capantoja/SIMM/SIMM/Hardware/Perifericos/Datasheet/ElecFreaks - Wiki_files/700px-NewTFT2.4-04-LGR.jpg

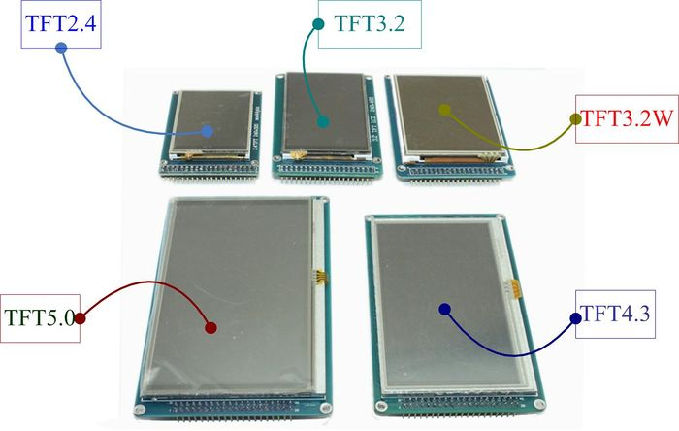
SIMM/Hardware/Perifericos/Datasheet/ElecFreaks - Wiki_files/700px-NewTFT2.4-04-LGR.jpg
