capantoja/SIMM/SIMM/Hardware/Perifericos/Datasheet/ElecFreaks - Wiki_files/450px-NewTFT4.3-01-LGR.jpg

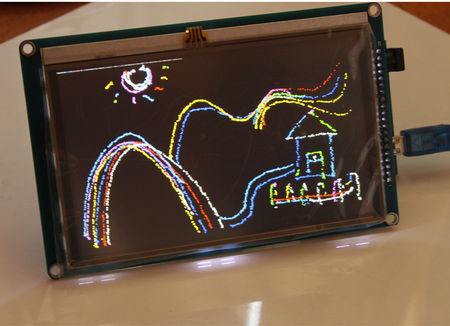
SIMM/Hardware/Perifericos/Datasheet/ElecFreaks - Wiki_files/450px-NewTFT4.3-01-LGR.jpg
