capantoja/SIMM/SIMM/Hardware/Perifericos/Datasheet/ElecFreaks - Wiki_files/450px-NewTFT4.3-02-LGR.jpg

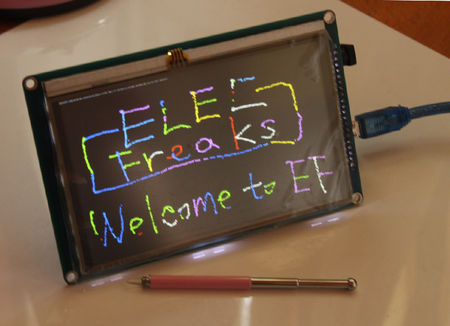
SIMM/Hardware/Perifericos/Datasheet/ElecFreaks - Wiki_files/450px-NewTFT4.3-02-LGR.jpg
