capantoja/SIMM/SIMM/Hardware/Perifericos/Datasheet/ElecFreaks - Wiki_files/450px-NewTFT.jpg

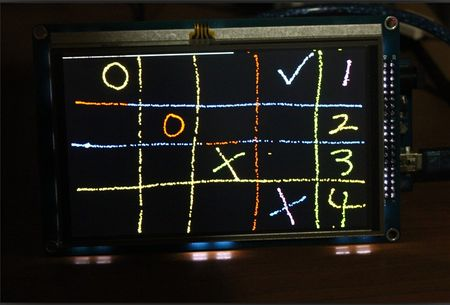
SIMM/Hardware/Perifericos/Datasheet/ElecFreaks - Wiki_files/450px-NewTFT.jpg
