capantoja/SIMM/SIMM/Hardware/Perifericos/Datasheet/ElecFreaks - Wiki_files/500px-TFT01-2.4-04.jpg

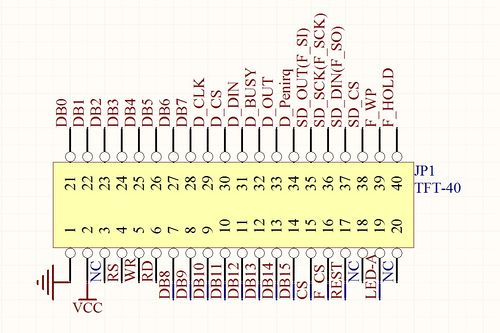
SIMM/Hardware/Perifericos/Datasheet/ElecFreaks - Wiki_files/500px-TFT01-2.4-04.jpg
