capantoja/SIMM/SIMM/Hardware/Perifericos/Datasheet/ElecFreaks - Wiki_files/500px-TFT4.3.jpg

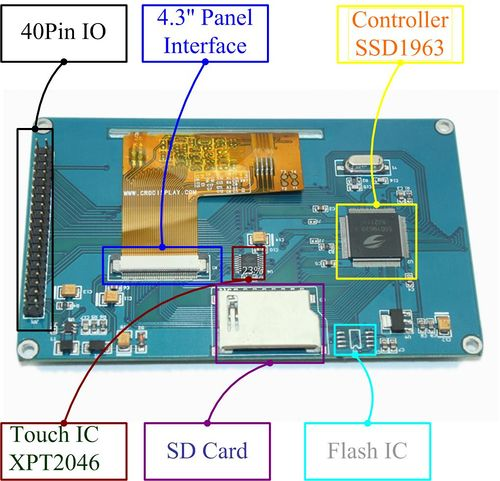
SIMM/Hardware/Perifericos/Datasheet/ElecFreaks - Wiki_files/500px-TFT4.3.jpg
