capantoja/SIMM/SIMM/Hardware/Perifericos/Datasheet/ElecFreaks - Wiki_files/600px-NewTFT4.3.jpg

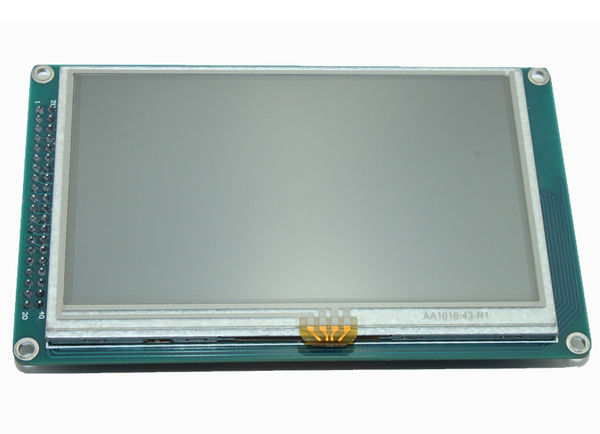
SIMM/Hardware/Perifericos/Datasheet/ElecFreaks - Wiki_files/600px-NewTFT4.3.jpg
