capantoja/SIMM/SIMM/Hardware/Perifericos/Datasheet/ElecFreaks - Wiki_files/700px-NewTFT4.3-06-LGR.jpg

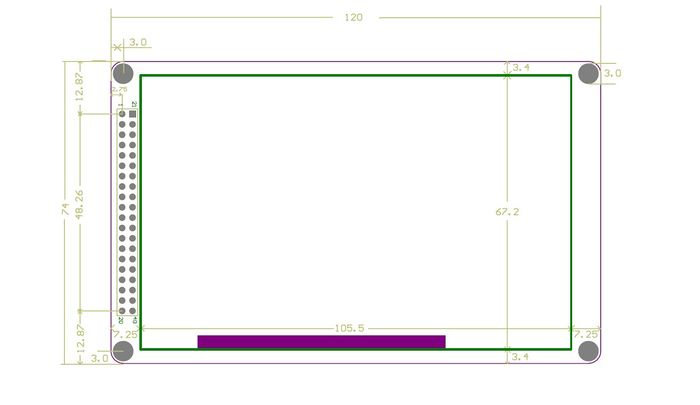
SIMM/Hardware/Perifericos/Datasheet/ElecFreaks - Wiki_files/700px-NewTFT4.3-06-LGR.jpg
