capantoja/SIMM/SIMM/Hardware/Perifericos/Datasheet/ElecFreaks - Wiki_files/700px-RGB.jpg.png

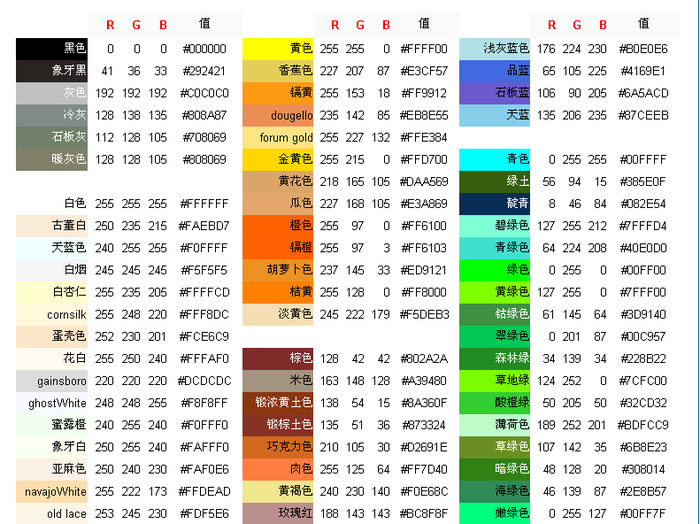
SIMM/Hardware/Perifericos/Datasheet/ElecFreaks - Wiki_files/700px-RGB.jpg.png
