capantoja/SIMM/SIMM/Hardware/Perifericos/Datasheet/Skylab GPS Module MT3329 SKM53 with Embedded GPS Antenna Arduino Compatible L   eBay_files/140.jpg

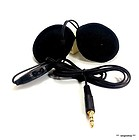
SIMM/Hardware/Perifericos/Datasheet/Skylab GPS Module MT3329 SKM53 with Embedded GPS Antenna Arduino Compatible L eBay_files/140.jpg
