capantoja/SIMM/SIMM/Hardware/Perifericos/Datasheet/Skylab GPS Module MT3329 SKM53 with Embedded GPS Antenna Arduino Compatible L   eBay_files/$(KGrHqUOKpIFGLuYINLOBRntztY36w~~60_1.JPG

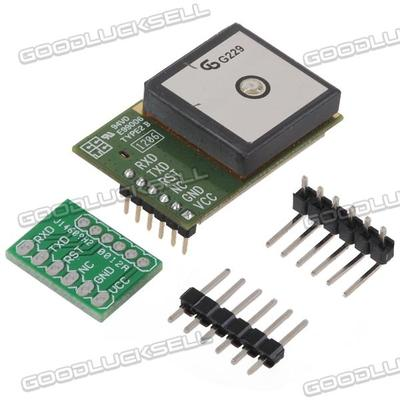
SIMM/Hardware/Perifericos/Datasheet/Skylab GPS Module MT3329 SKM53 with Embedded GPS Antenna Arduino Compatible L eBay_files/$(KGrHqUOKpIFGLuYINLOBRntztY36w~~60_1.JPG
