capantoja/SIMM/SIMM/Hardware/Perifericos/Datasheet/Skylab GPS Module MT3329 SKM53 with Embedded GPS Antenna Arduino Compatible L   eBay_files/sku_86236_2.jpg

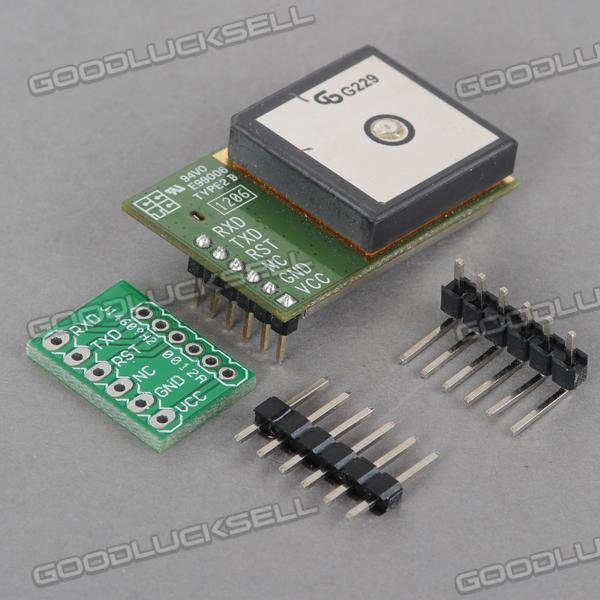
SIMM/Hardware/Perifericos/Datasheet/Skylab GPS Module MT3329 SKM53 with Embedded GPS Antenna Arduino Compatible L eBay_files/sku_86236_2.jpg
