capantoja/SIMM/SIMM/Hardware/Perifericos/img001.jpg

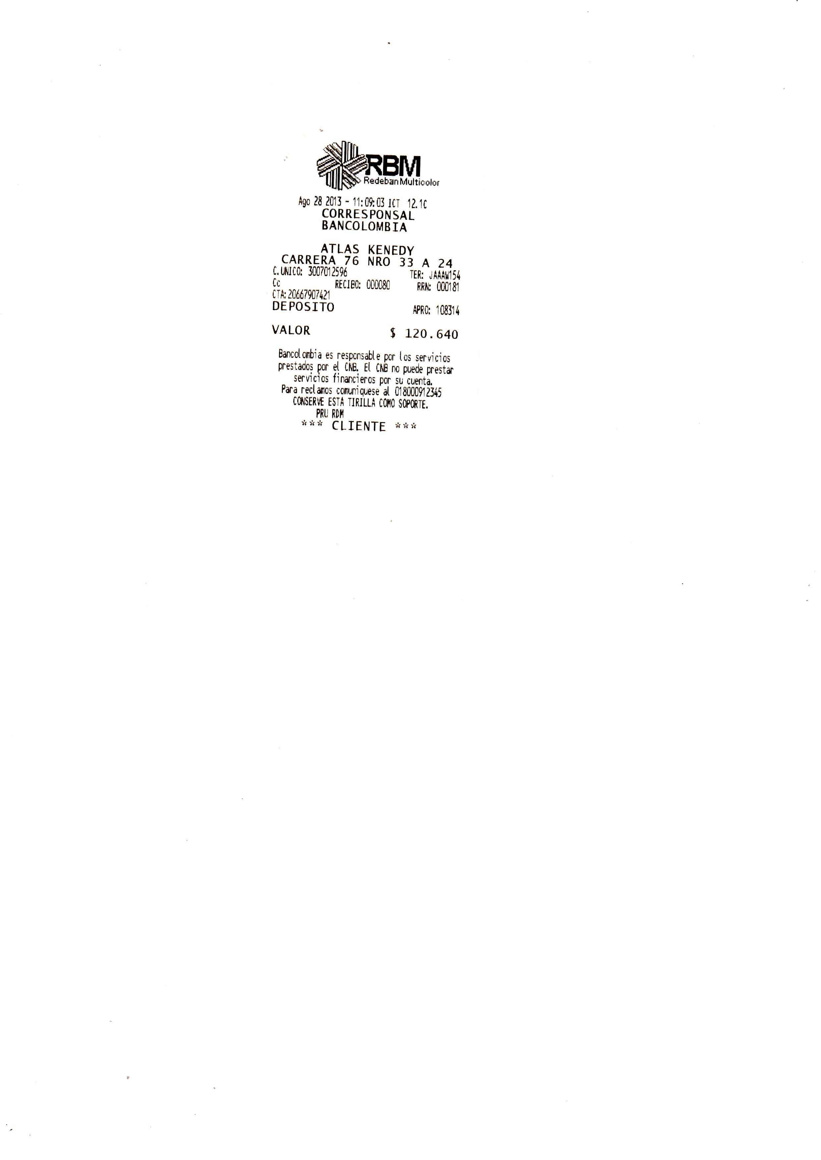
SIMM/Hardware/Perifericos/img001.jpg
