capantoja/SIMM/SIMM/Software/SIMM/Fondo.png

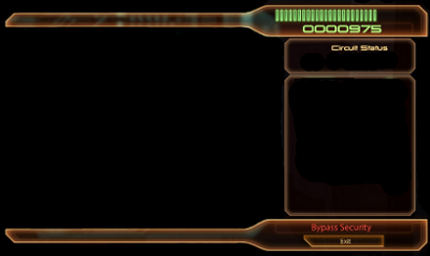
SIMM/Software/SIMM/Fondo.png
