capantoja/SIMM/SIMM/Hardware/Perifericos/BOM.pdf

### Sheet1

### Page 1

DESCRIPCION | ORDEN | ENCAPSULADO | CANTIDAD | PROVEEDOR | REFERENCIA | CODIGO | VALOR UNITARIO | VALOR TOTAL
50pF | C7 | SM0402 | 1 | Sigma | CC0402 68PF50V | | 58 | 580
0.1uF | C6 | SM0805 | 1 | Sigma | CC0805 0.1UF50 | | 58 | 580
0.47uF | C3 | SM1206 | 1 | Tekcien | CC1206CX7R4 | QP0605 | 600 | 600
1uF | C2,C5 | SM0805 | 2 | YO | | | 0 | 0
10uF | C1 | SM1206 | 1 | YO | | | 0 | 0
33uF ELEC | C4 | SM1206 | 1 | Tekcien | | QX0300 | 500 | 500
DIODO ZENER 5V1 | D1,D2,D3,D4,D5,D6 THRU HOLE | | 6 | Av 9 | | | 200 | 1200
CONN AUDIO JACK | J1 | SMD | 1 | Sigma | CON 3.5MM SMD | | 754 | 754
USB CONN | J2 | SMD | 1 | yo | | | 0 | 0
USB MINI CONN | J3 | THRU HOLE | 1 | yo | | | 0 | 0
JUMPER | JP4 | THRU HOLE | 1 | Av 9 | | | 200 | 200
CONN | K1 | THRU HOLE | 1 | Av 9 | | | 200 | 200
FERRITE 500 OHM | L1,L2,L3,L4,L5,L6 SM0805 | | 6 | Sigma | MI0805K400R | | 290 | 1740
CONN 12X2 | P1,P2,P3,P4 | THRU HOLE | 4 | Sigma | REGLETA 40 X 2 | | 435 | 1740
CONN GPS | P5 | THRU HOLE | 1 | Av 9 | | | 200 | 200
CONN 2 | P6 | THRU HOLE | 1 | Av 9 | | | 200 | 200
CONN 10 | P7 | THRU HOLE | 1 | Av 9 | | | 700 | 700
BNC CONN | P8 | THRU HOLE | 1 | Av 9 | | | 700 | 700
RES 100 OHM | R7,R8 | SM1206 | 2 | Sigma | | | 35 | 350
RES 470 OHM | R11,R12,R13,R14,R15,R16,R20,R21,R22,R23,R24,R25 SM1206 | | 12 | Sigma | | | 35 | 700
RES 10K OHM | R1,R2,R17,R18,R19 SM1206 | | 5 | Sigma | | | 35 | 350
RES 47K OHM | R26,R27,R28 | SM1206 | 3 | Sigma | | | 35 | 350
RES 100K OHM | R3,R4,R5,R6,R29,R30,R31,R32,R33,R34 SM1206 | | 10 | Sigma | | | 35 | 350
MINI SWITCH | SW1,SW2,SW3,SW4 SM1206 | | 4 | Av9 | | | 600 | 2400
ESD9B3.3ST5G | TVS1,TVS2 | SM1206 | 2 | | | | 0 | 0
LM2940 | U1 | TO-220ECS | 1 | Sigma | LM2940CT-5 | | 2900 | 2900
MOCD213 | U2,U3,U4 | SOIC8 | 3 | Sigma | MOCD213 | | 1914 | 5742
LM324M | U5 | SOP14 | 1 | Sigma | LM324M | | 638 | 638
| | | | | | | SUBTOTAL | 23674
| | | | | | | IVA APROX | 3787,84
| | | | | | | TOTAL APROX | 27461,84
