capantoja/SIMM/SIMM/Hardware/StampMini/i.mx233stamp.pdf

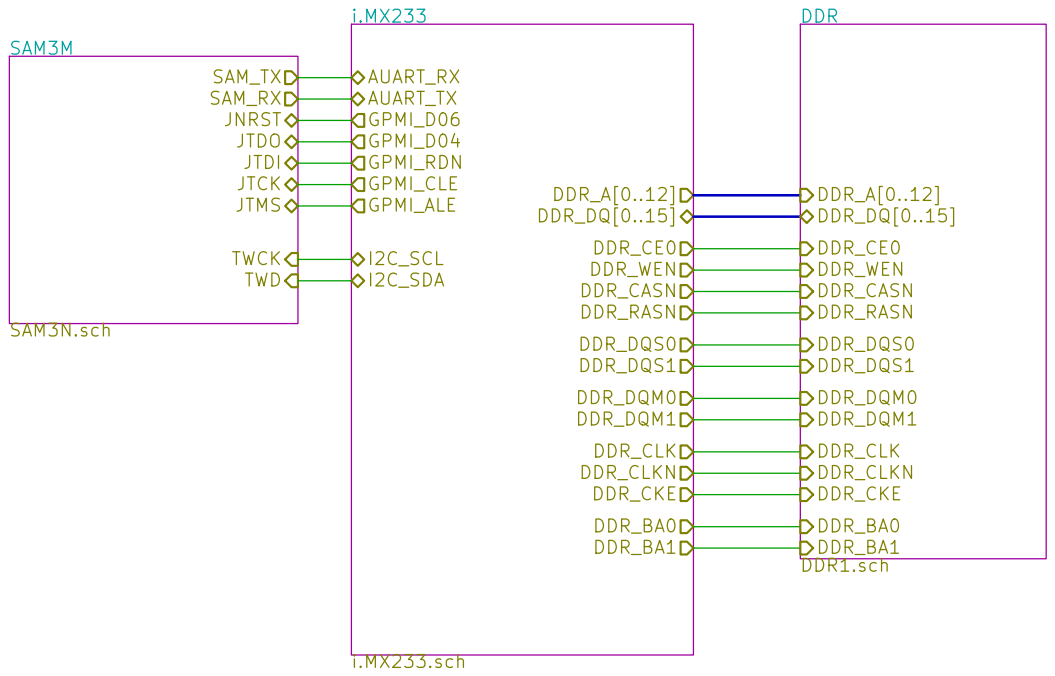
[picture p19: page 1]

Id: 1/4 Title: File: i.mx233stamp.sch
Sheet: /

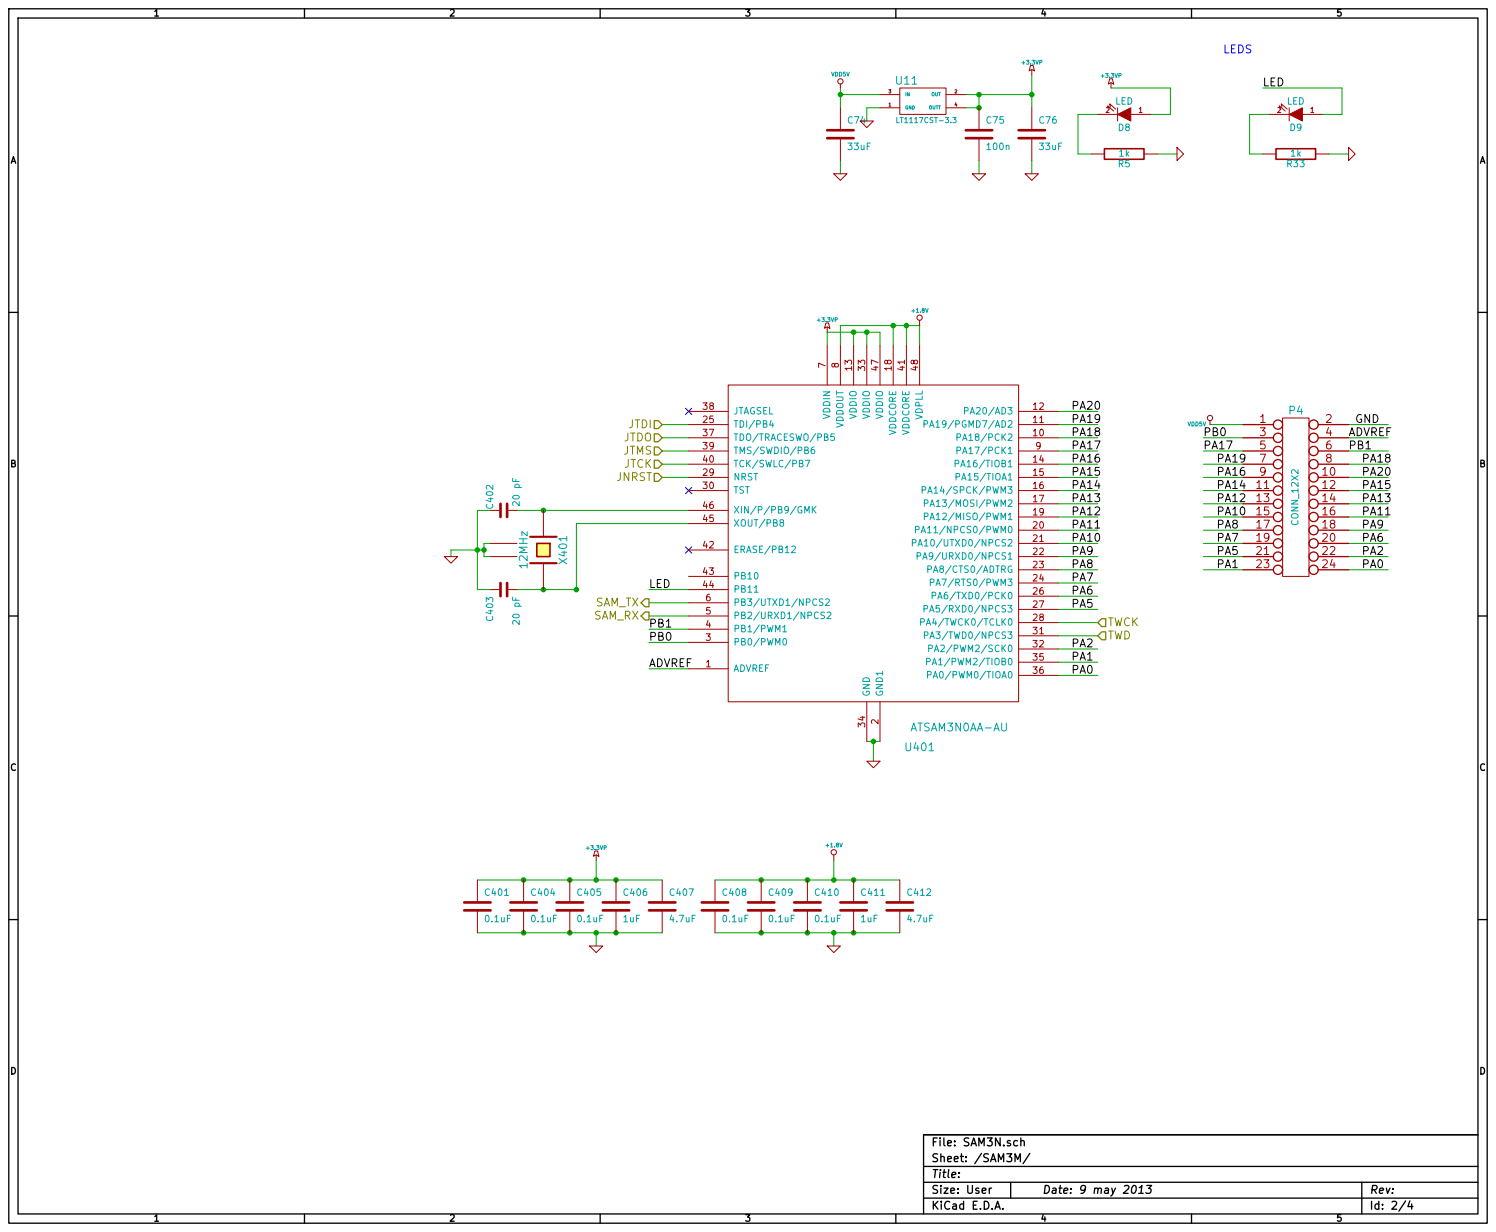
[picture p20: page 2]

8 PA17/PCK1 9 PA18/PCK2 10 PA11/NPCS0/PWM0 20 TST 30 TCK/SWLC/PB7 40 PA19/PGMD7/AD2 11 PA10/UTXD0/NPCS2 21 PA3/TWD0/NPCS3 31 VDDCORE 41 PA20/AD3 12 PA9/URXD0/NPCS1 22 PA2/PWM2/SCK0 32 ERASE/PB12 42 VDDIO 13 PA8/CTS0/ADTRG 23 VDDIO 33 PB10 43 PA16/TIOB1 14 PA7/RTS0/PWM3 24 GND 34 PB11 44 PA15/TIOA1 15 TDI/PB4 25 PA1/PWM2/TIOB0 35 XOUT/PB8 45 PA14/SPCK/PWM3 16 PA6/TXD0/PCK0 26 PA0/PWM0/TIOA0 36 XIN/P/PB9/GMK 46 PA13/MOSI/PWM2 17 PA5/RXD0/NPCS3 27 TDO/TRACESWO/PB5 37 VDDIO 47 VDDCORE 18 PA4/TWCK0/TCLK0 28

Id: 2/4 Title: File: SAM3N.sch
Sheet: /SAM3M/

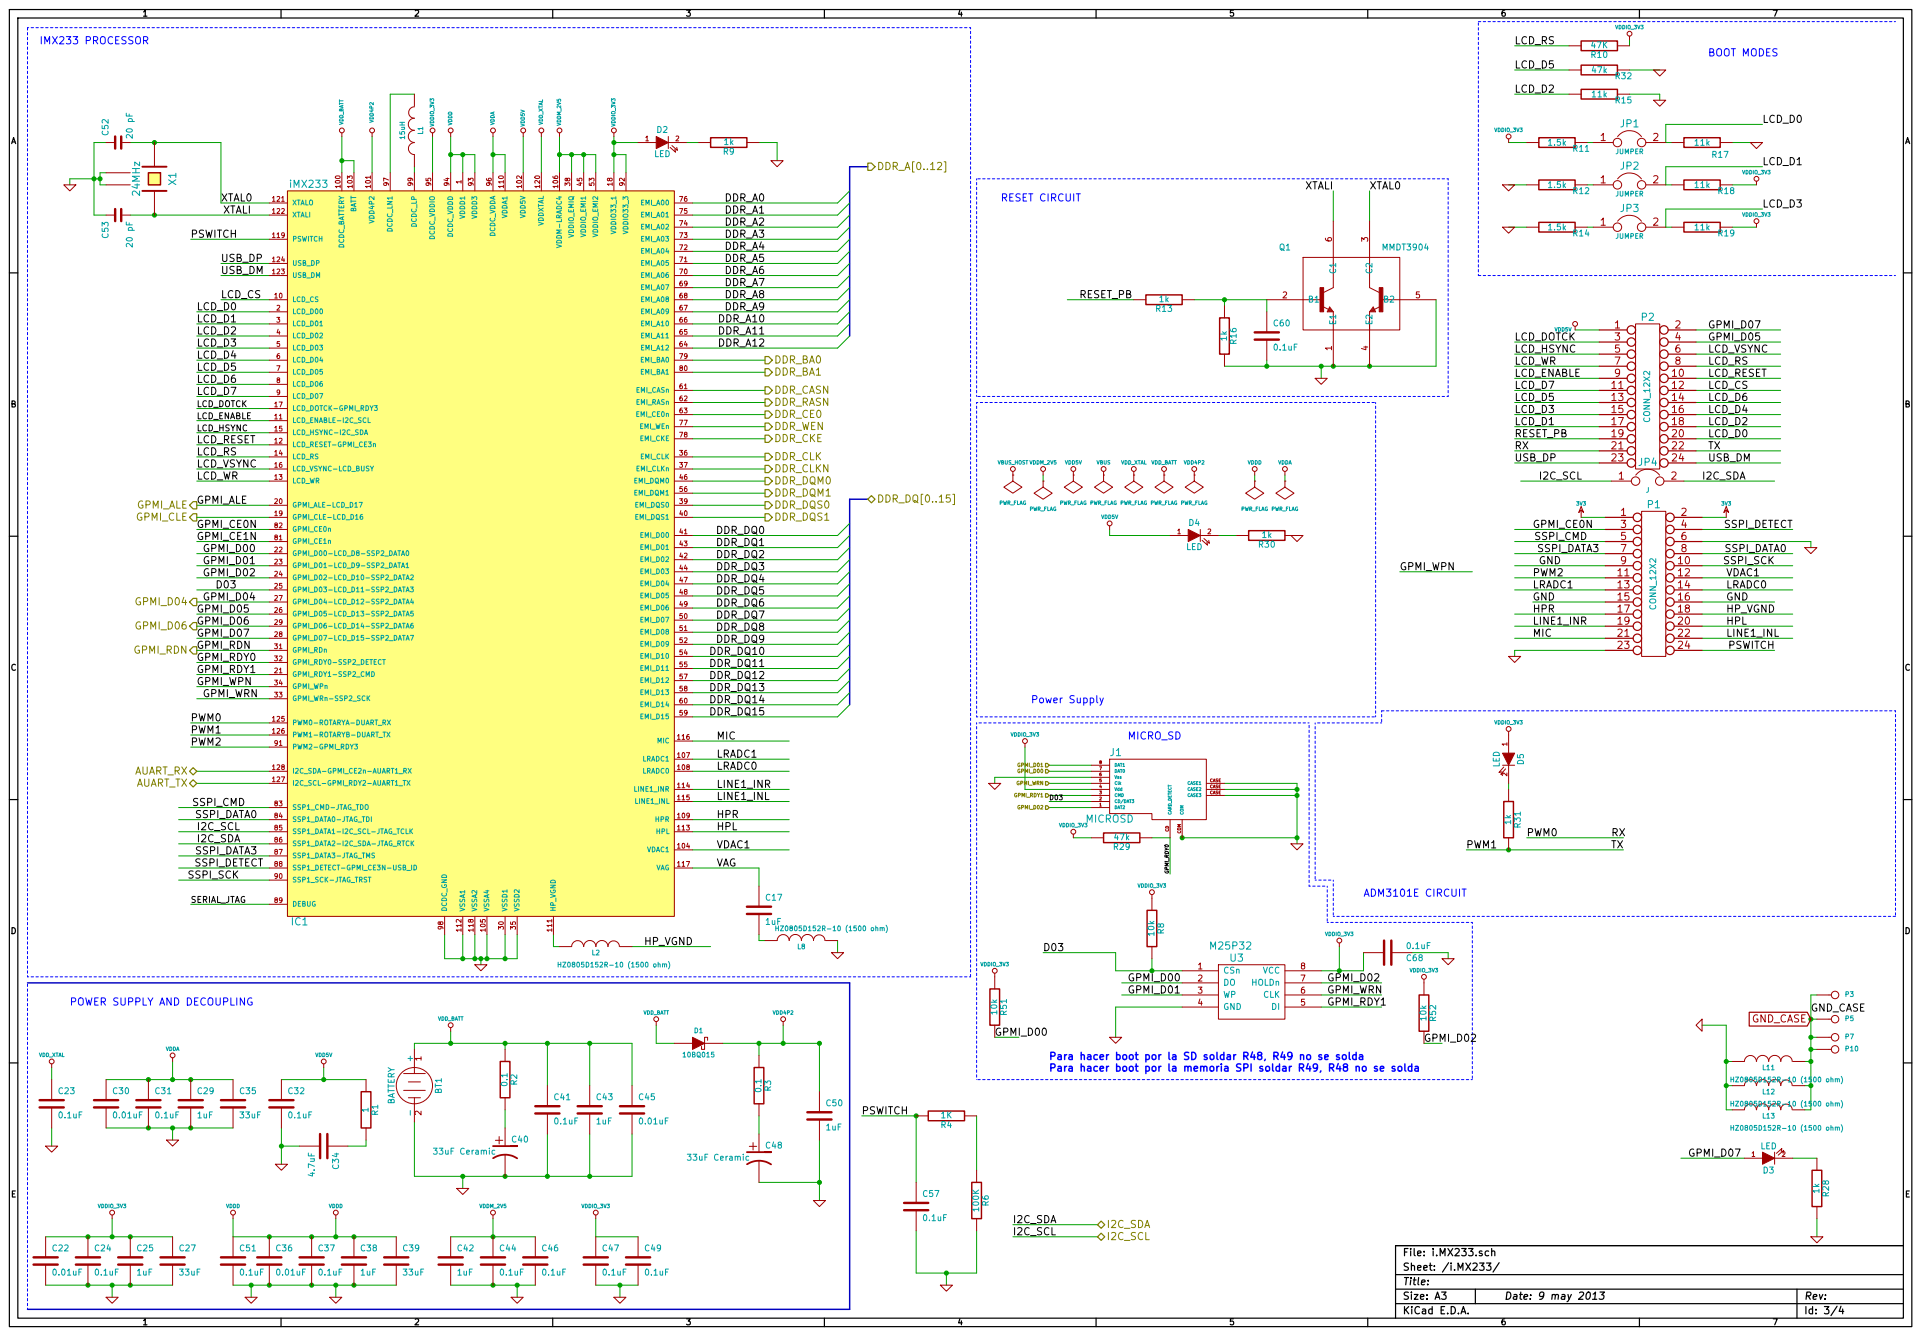
[picture p21: page 3]

Schematic Symbol Drawn By Opendous Inc. www.opendous.org VDDD1

POWER SUPPLY AND DECOUPLING

Para hacer boot por la SD soldar R48, R49 no se solda
Para hacer boot por la memoria SPI soldar R49, R48 no se solda

Id: 3/4 Title: File: i.MX233.sch Sheet: /i.MX233/

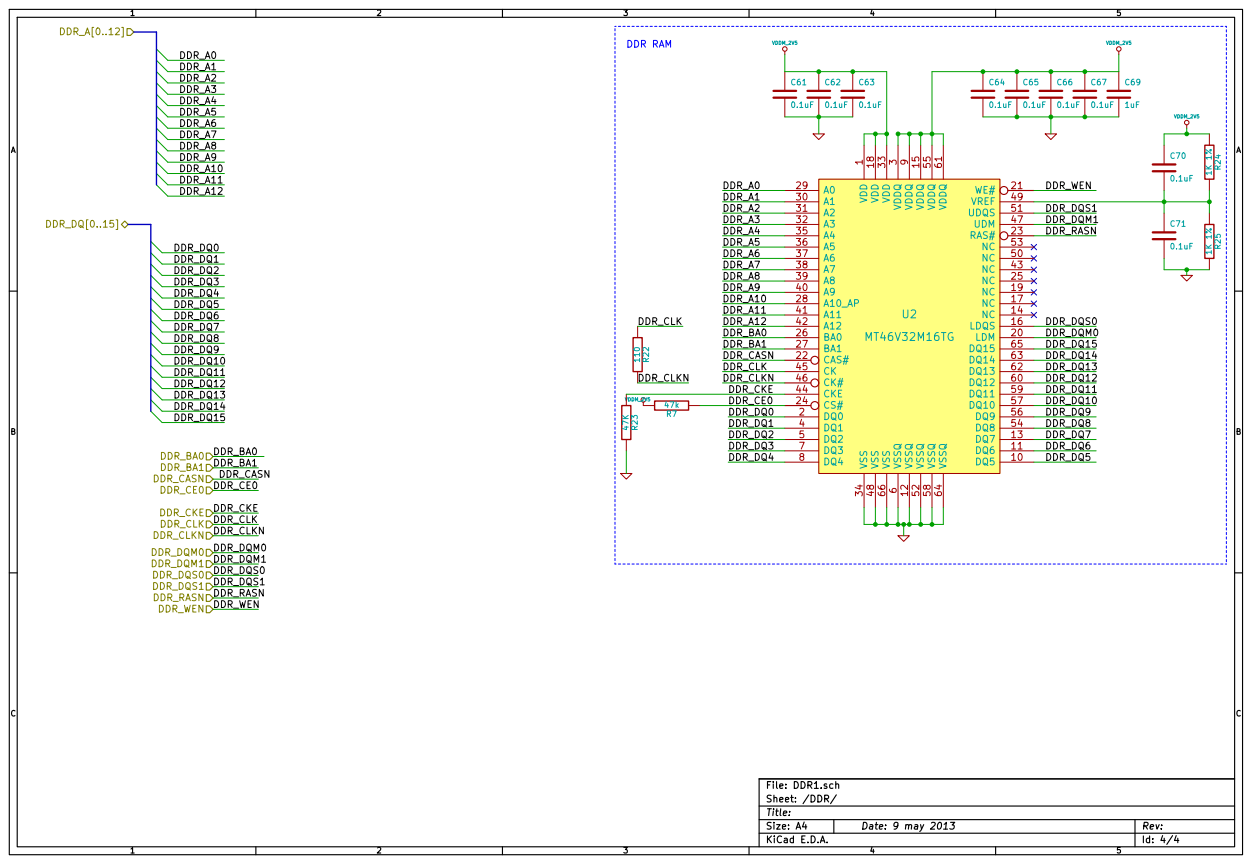
[picture p22: page 4]

Id: 4/4 Title: File: DDR1.sch Sheet: /DDR/
