capantoja/SIMM/SIMM/Hardware/Perifericos/ENTRADAS.sch

## KiCad design SIMM/Hardware/Perifericos/ENTRADAS.sch (2013-09-26)

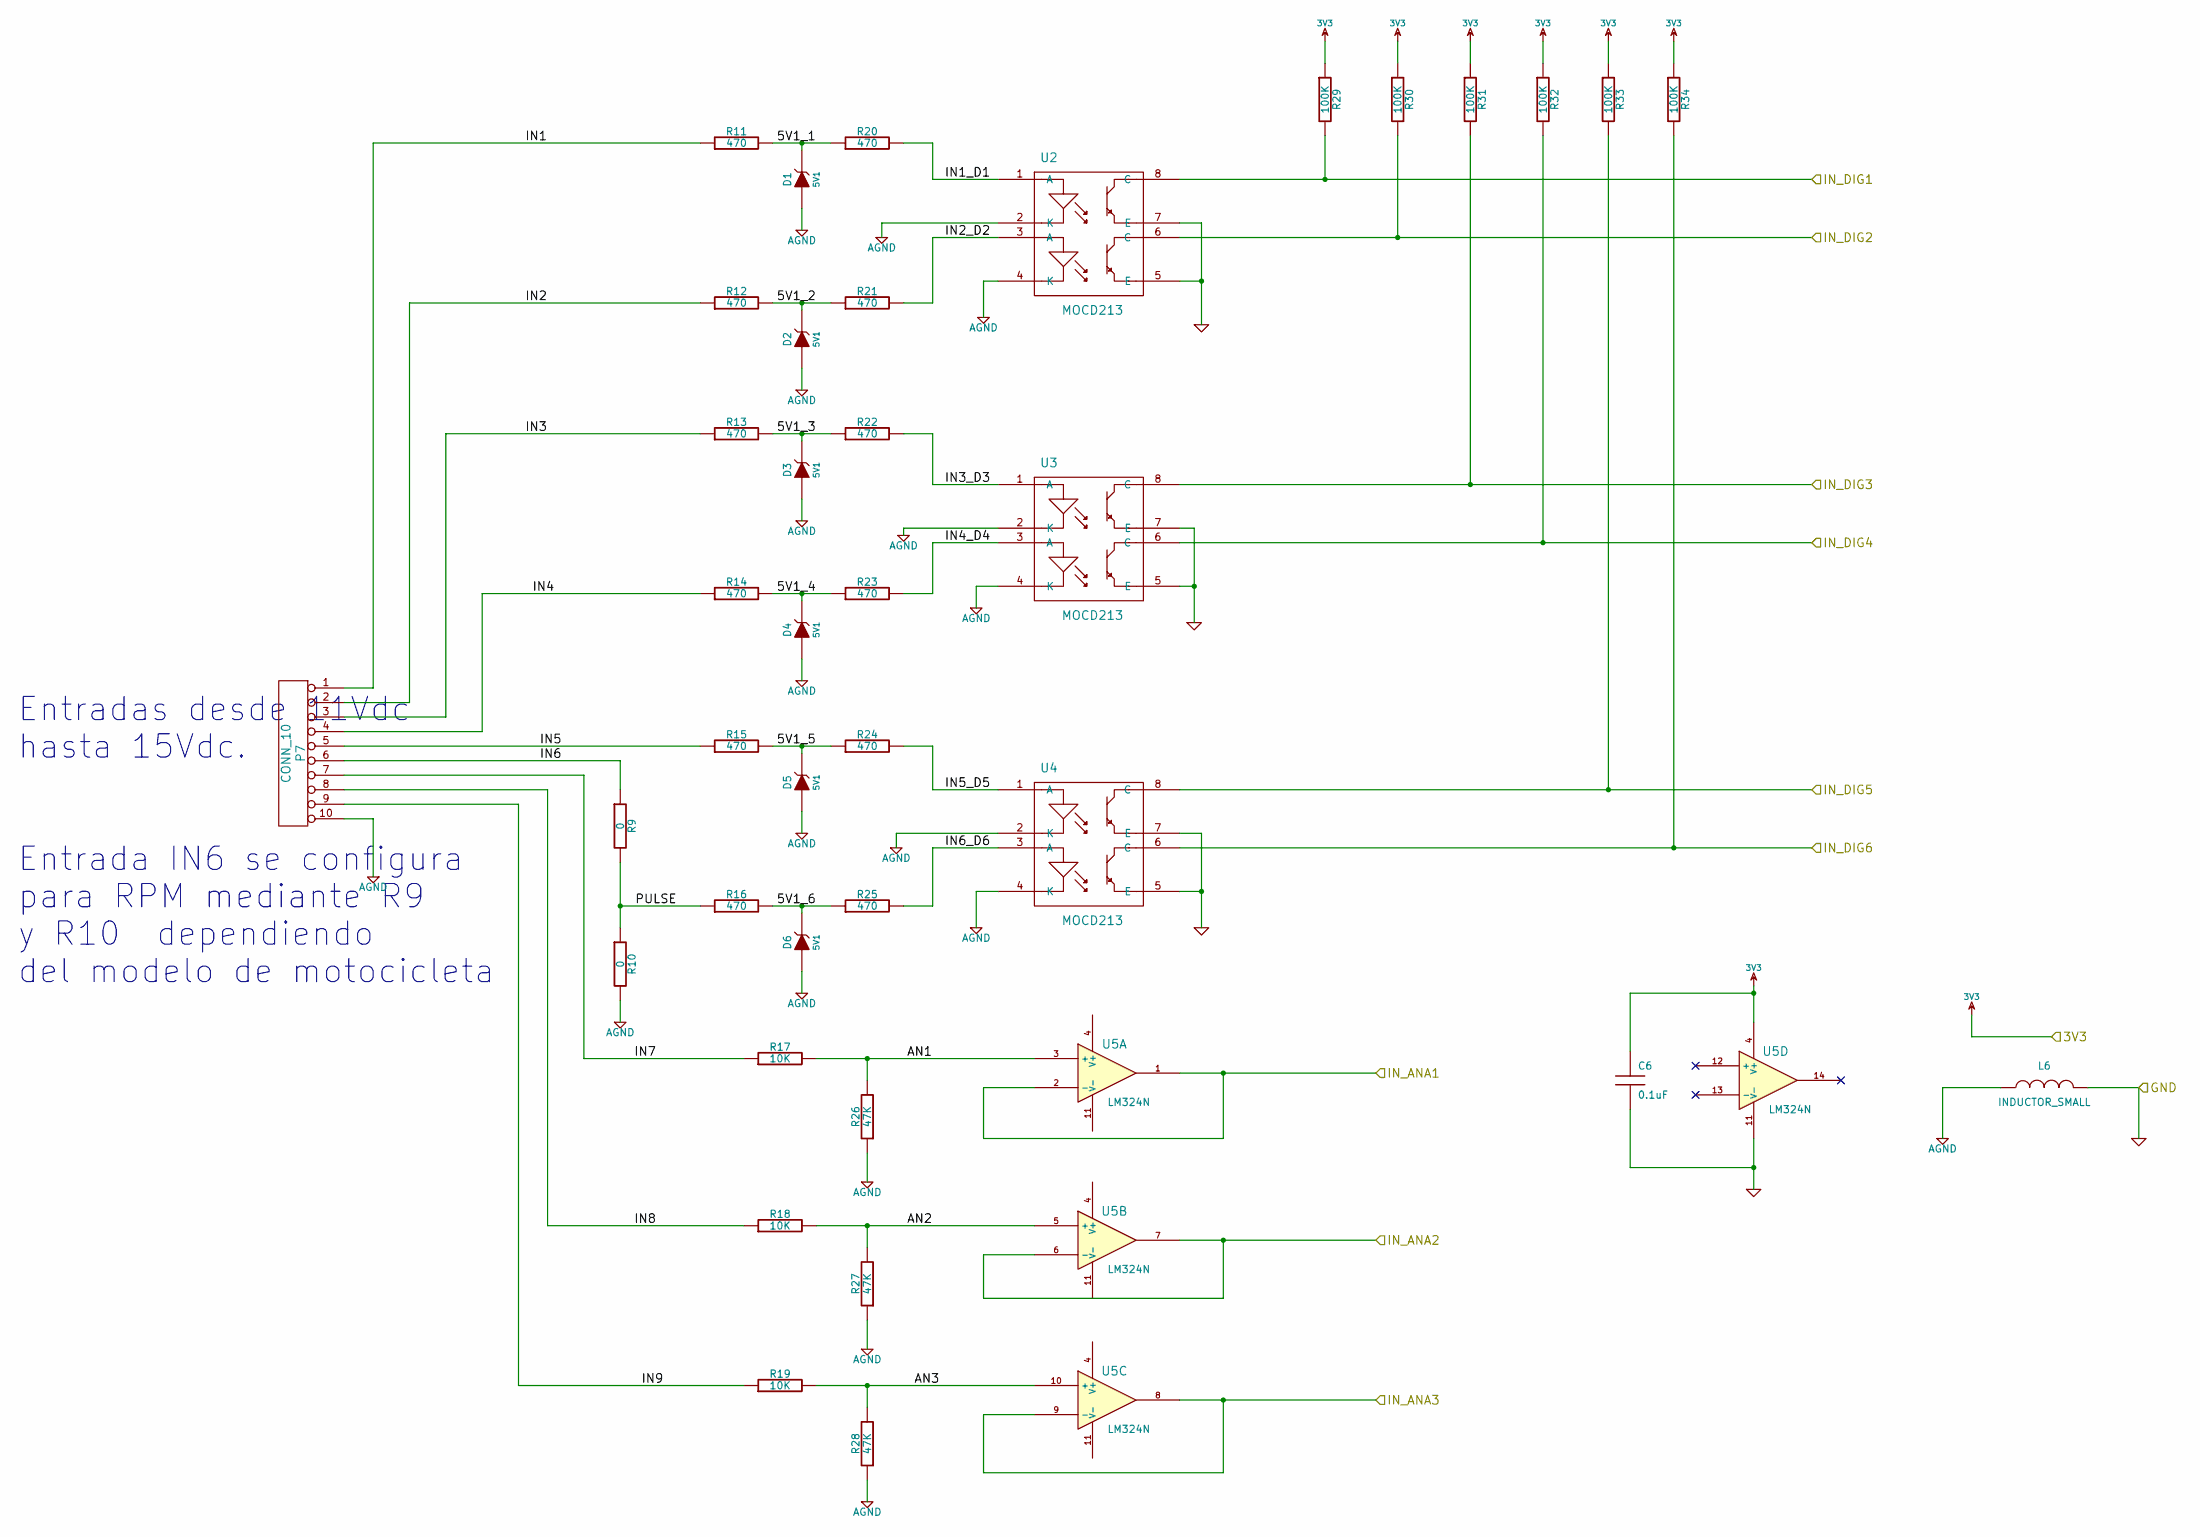
[picture p23: schematic ENTRADAS.sch]

Parts:
C6: 0.1uF; SM0805
D1, D2, D3, D4, D5, D6: 5V1
L6: INDUCTOR_SMALL
P7: CONN_10
R9, R10: 0
R11, R12, R13, R14, R15, R16, R20, R21, R22, R23, R24, R25: 470
R17, R18, R19: 10K; SM0805
R26, R27, R28: 47K; SM0805
R29, R30, R31, R32, R33, R34: 100K; SM0805
U2, U3, U4: MOCD213
U5: LM324N

Connections:
3V3: C6.1, R29.1, R30.1, R31.1, R32.1, R33.1, R34.1, U5.4 (V+)
5V1_1: D1.2 (K), R11.2, R20.1
5V1_2: D2.2 (K), R12.2, R21.1
5V1_3: D3.2 (K), R13.2, R22.1
5V1_4: D4.2 (K), R14.2, R23.1
5V1_5: D5.2 (K), R15.2, R24.1
5V1_6: D6.2 (K), R16.2, R25.1
AGND: D1.1 (A), D2.1 (A), D3.1 (A), D4.1 (A), D5.1 (A), D6.1 (A), L6.1, P7.10, R10.2, R26.1, R27.1, R28.1, U2.2 (K), U2.4 (K), U3.2 (K), U3.4 (K), U4.2 (K), U4.4 (K)
AN1: R17.2, R26.2, U5.3 (+)
AN2: R18.2, R27.2, U5.5 (+)
AN3: R19.2, R28.2, U5.10 (+)
GND: C6.2, L6.2, U2.5 (E), U2.7 (E), U3.5 (E), U3.7 (E), U4.5 (E), U4.7 (E), U5.11 (V-)
IN1: P7.1, R11.1
IN1_D1: R20.2, U2.1 (A)
IN2: P7.2, R12.1
IN2_D2: R21.2, U2.3 (A)
IN3: P7.3, R13.1
IN3_D3: R22.2, U3.1 (A)
IN4: P7.4, R14.1
IN4_D4: R23.2, U3.3 (A)
IN5: P7.5, R15.1
IN5_D5: R24.2, U4.1 (A)
IN6: P7.6, R9.1
IN6_D6: R25.2, U4.3 (A)
IN7: P7.7, R17.1
IN8: P7.8, R18.1
IN9: P7.9, R19.1
IN_ANA1: U5.1, U5.2 (-)
IN_ANA2: U5.6 (-), U5.7
IN_ANA3: U5.8, U5.9 (-)
IN_DIG1: R29.2, U2.8 (C)
IN_DIG2: R30.2, U2.6 (C)
IN_DIG3: R31.2, U3.8 (C)
IN_DIG4: R32.2, U3.6 (C)
IN_DIG5: R33.2, U4.8 (C)
IN_DIG6: R34.2, U4.6 (C)
PULSE: R9.2, R10.1, R16.1

Notes on the sheet:
Entradas desde 11Vdc hasta 15Vdc. Entrada IN6 se configura para RPM mediante R9 y R10 dependiendo del modelo de motocicleta
