capantoja/SIMM/SIMM/Hardware/Perifericos/SIMM.sch

## KiCad design SIMM/Hardware/Perifericos/SIMM.sch (2013-09-26)

Schematic: SIMM.sch

Parts:
C1: 10uF; SM1206
C2, C5: 1uF; SM0805
C3: 0.47uF; SM1206
C4: 33uF; SM1206
C7: 50pF; SM0805
J1: JACK_3P
J2: USB_2
J3: USB-MINI
JP4: JUMPER
L1, L5: 470 OHMS
L2, L3, L4: 500 OHM 100MHZ
P1, P2, P4: CONN_12X2
P3: CONN_20X2
P5: GPS SKYLAB
P6: CONN_2
P8: BNC
P9: Bluetooth
R1, R2: 10K; SM0805
R3, R4, R5, R6: 100K; SM0805
R7, R8: 100
SW1: UP
SW2: DOWN
SW3: ENTER
SW4: PAGE
TVS1, TVS2: ESD9B3.3ST5G
U1: LM2940
