capantoja/SIMM/SIMM/Hardware/StampMini/LCD.sch

## KiCad design SIMM/Hardware/StampMini/LCD.sch (2013-09-21)

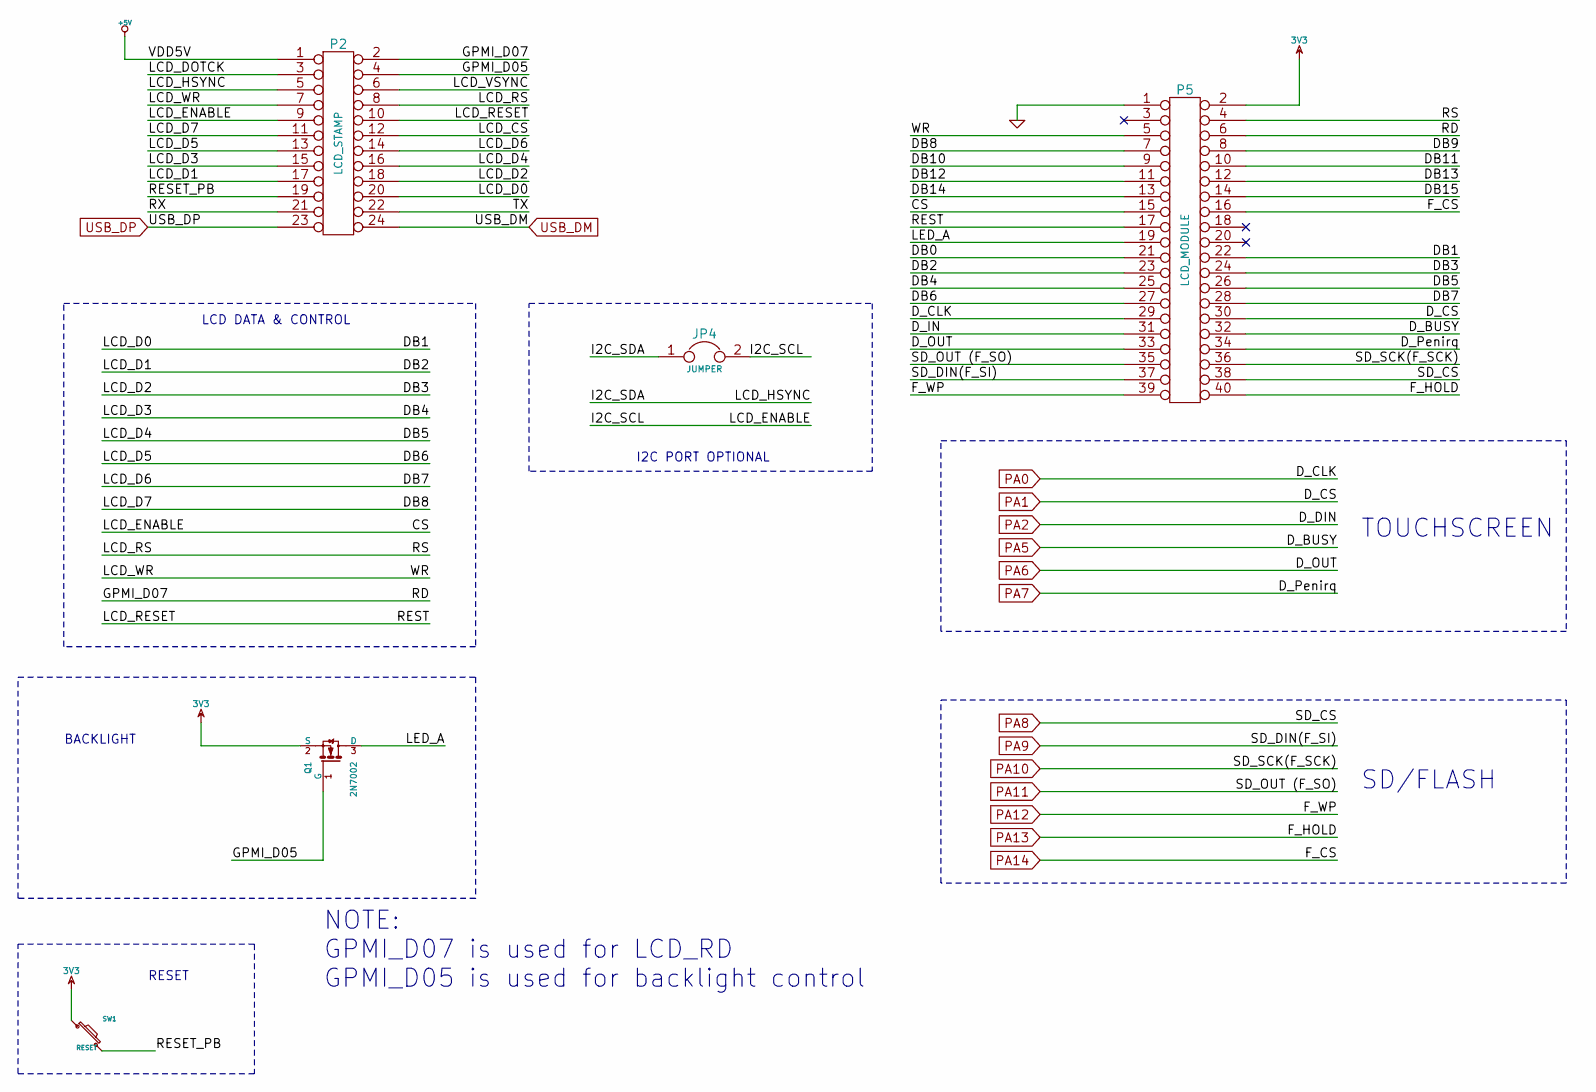
[picture p24: schematic LCD.sch]

Parts:
JP4: JUMPER
P2: LCD_STAMP
P5: LCD_MODULE
Q1: 2N7002
SW1: RESET

Connections:
3V3: P5.2, Q1.2 (S), SW1.1
+5V: P2.1
CS: JP4.2, P2.9, P5.15
DB0: P5.21
DB1: P2.20, P5.22
DB2: P2.17, P5.23
DB3: P2.18, P5.24
DB4: P2.15, P5.25
DB5: P2.16, P5.26
DB6: P2.13, P5.27
DB7: P2.14, P5.28
DB8: P2.11, P5.7
DB9: P5.8
DB10: P5.9
DB11: P5.10
DB12: P5.11
DB13: P5.12
DB14: P5.13
DB15: P5.14
D_IN: P5.31
GND: P5.1
GPMI_D05: P2.4, Q1.1 (G)
GPMI_D07: P2.2, P5.6
I2C_SDA: JP4.1, P2.5
LCD_CS: P2.12
LCD_DOTCK: P2.3
LCD_RESET: P2.10, P5.17
LCD_RS: P2.8, P5.4
LCD_VSYNC: P2.6
LCD_WR: P2.7, P5.5
LED_A: P5.19, Q1.3 (D)
PA0: P5.29
PA1: P5.30
PA5: P5.32
PA6: P5.33
PA7: P5.34
PA8: P5.38
PA9: P5.37
PA10: P5.36
PA11: P5.35
PA12: P5.39
PA13: P5.40
PA14: P5.16
RESET_PB: P2.19, SW1.2
RX: P2.21
TX: P2.22
USB_DM: P2.24
USB_DP: P2.23

Notes on the sheet:
NOTE: GPMI_D07 is used for LCD_RD GPMI_D05 is used for backlight control
SD/FLASH
TOUCHSCREEN
RESET
BACKLIGHT
LCD DATA & CONTROL
I2C PORT OPTIONAL
