capantoja/SIMM/SIMM/Hardware/StampMini/MAIN.sch

## KiCad design SIMM/Hardware/StampMini/MAIN.sch (2013-09-21)

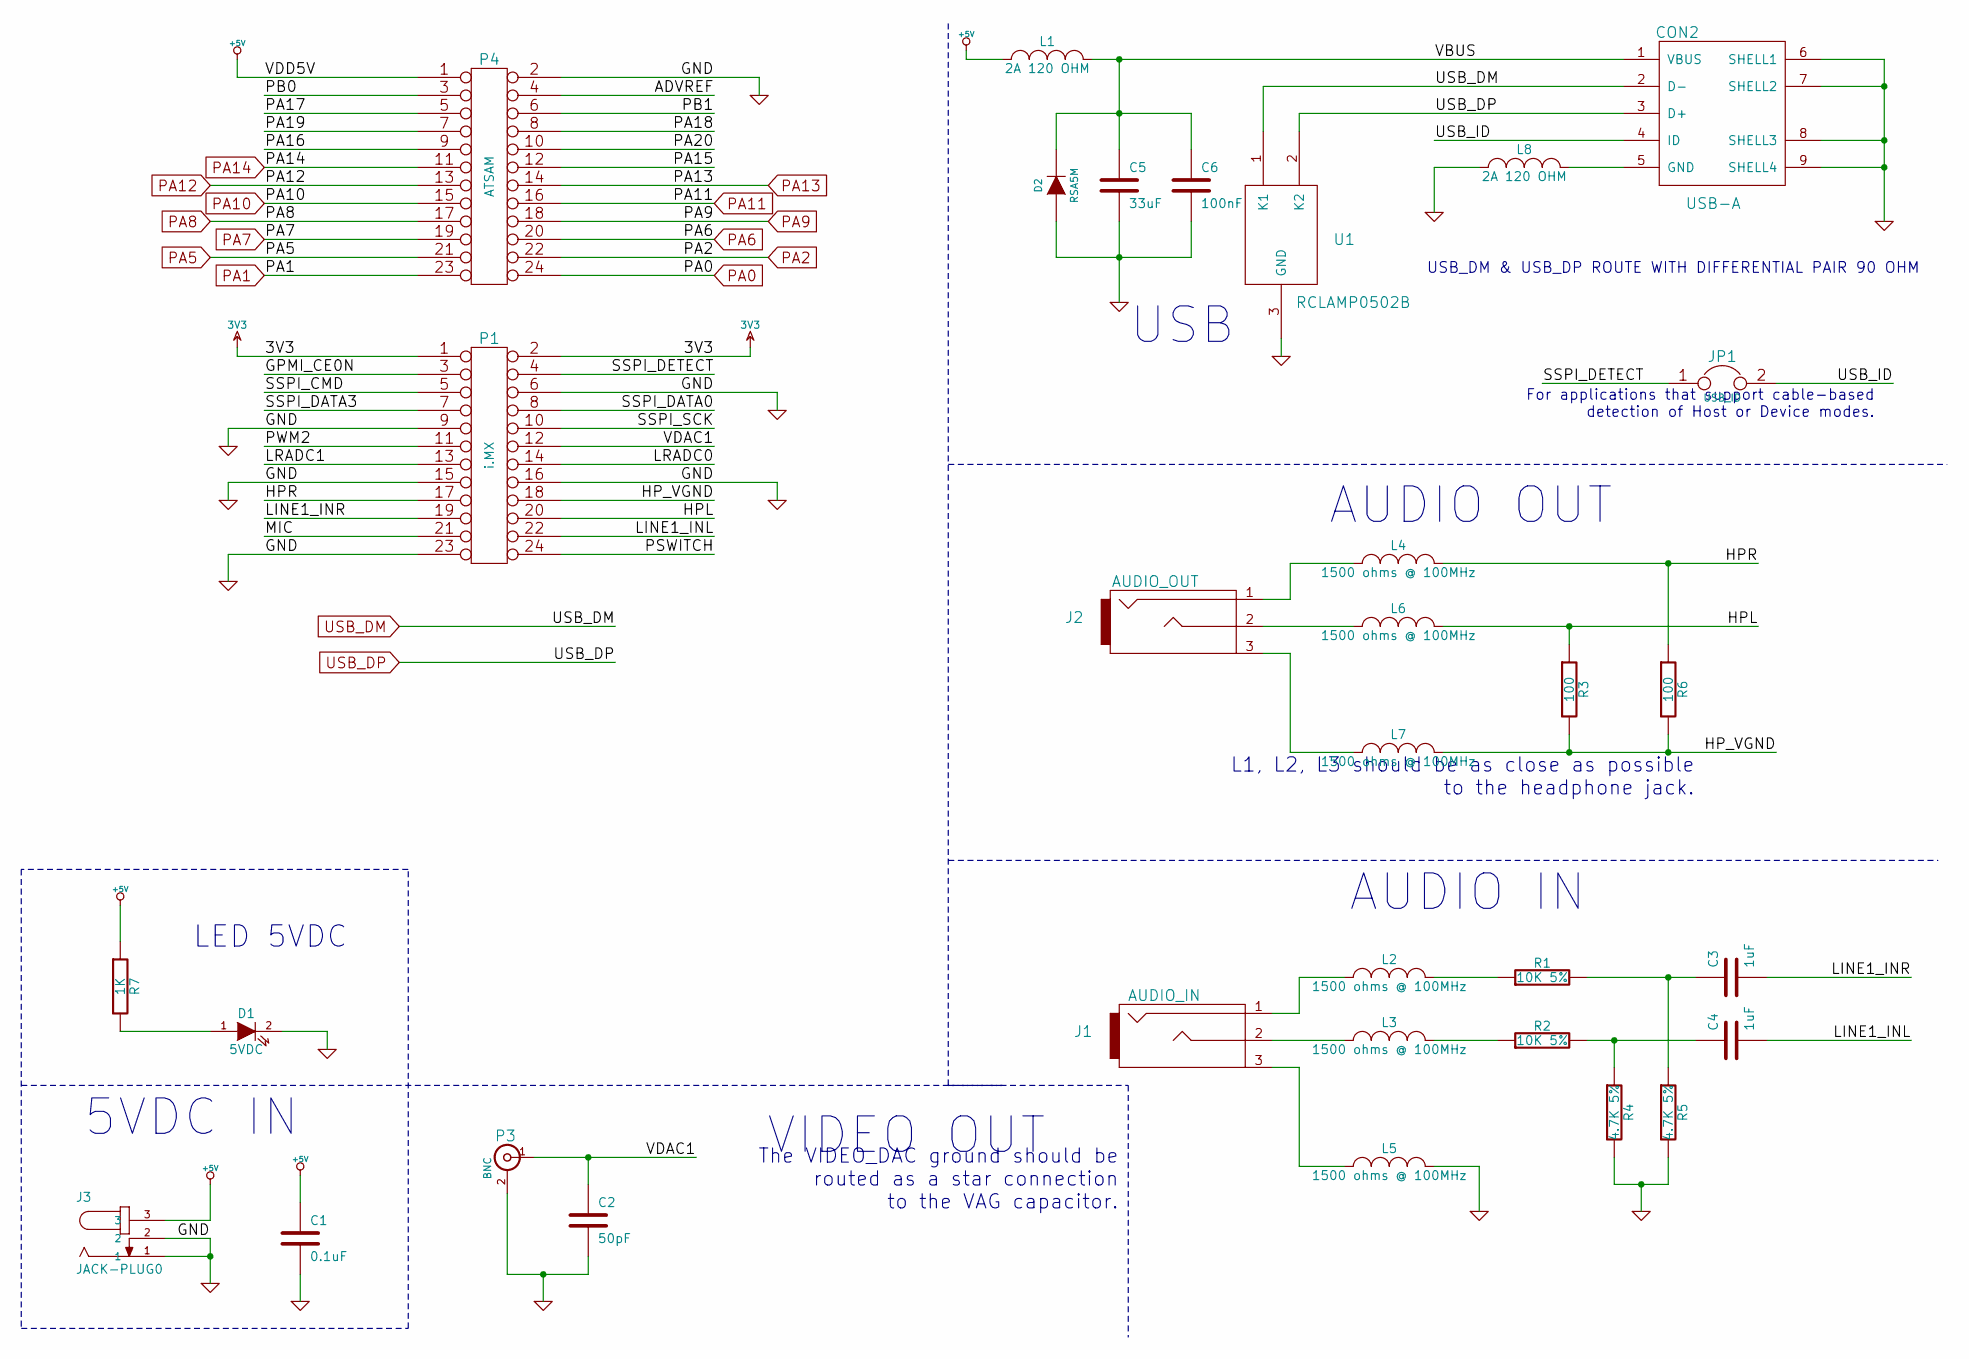
[picture p25: schematic MAIN.sch]

Parts:
C1: 0.1uF; SM0603
C2: 50pF; SM0805
C3, C4: 1uF; SM0603
C5: 33uF; SM1206
C6: 100nF; SM0603
CON2: USB-A; CONN USB-A Vertical
D1: 5VDC; SM0603
D2: RSA5M; SM1206
J1: AUDIO_IN
J2: AUDIO_OUT
J3: JACK-PLUG0; con-jack-SPC4077
JP1: USB_ID
L1, L8: 2A 120 OHM; SM0805
L2, L3, L4, L5, L6, L7: 1500 ohms @ 100MHz; SM0805
P1: i.MX
P3: BNC
P4: ATSAM
R1, R2: 10K 5%; SM0603
R3, R6: 100; SM0603
R4, R5: 4.7K 5%; SM0603
R7: 1K; SM0603
U1: RCLAMP0502B; SOT523

Connections:
3V3: P1.1, P1.2
+5V: C1.1, J3.3, L1.1, P4.1, R7.1
ADVREF: P4.4
GND: C1.2, C2.2, C5.2, C6.2, CON2.6 (SHELL1), CON2.7 (SHELL2), CON2.8 (SHELL3), CON2.9 (SHELL4), D1.2 (K), D2.1 (A), J3.1, J3.2, L5.2, L8.1, P1.6, P1.9, P1.15, P1.16, P1.23, P3.2 (Ext), P4.2, R4.2, R5.2, U1.3 (GND)
GPMI_CE0N: P1.3
HPL: L6.2, P1.20, R3.1
HPR: L4.2, P1.17, R6.1
HP_VGND: L7.2, P1.18, R3.2, R6.2
LINE1_INL: C4.2, P1.22
LINE1_INR: C3.2, P1.19
LRADC0: P1.14
LRADC1: P1.13
MIC: P1.21
unnamed: C3.1, R1.2, R5.1
unnamed: C4.1, R2.2, R4.1
unnamed: CON2.5 (GND), L8.2
unnamed: D1.1 (A), R7.2
unnamed: J1.1, L2.1
unnamed: J1.2, L3.1
unnamed: J1.3, L5.1
unnamed: J2.1, L4.1
unnamed: J2.2, L6.1
unnamed: J2.3, L7.1
unnamed: L2.2, R1.1
unnamed: L3.2, R2.1
PA0: P4.24
PA1: P4.23
PA2: P4.22
PA5: P4.21
PA6: P4.20
PA7: P4.19
PA8: P4.17
PA9: P4.18
PA10: P4.15
PA11: P4.16
PA12: P4.13
PA13: P4.14
PA14: P4.11
PA15: P4.12
PA16: P4.9
PA17: P4.5
PA18: P4.8
PA19: P4.7
PA20: P4.10
PB0: P4.3
PB1: P4.6
PSWITCH: P1.24
PWM2: P1.11
SSPI_CMD: P1.5
SSPI_DATA0: P1.8
SSPI_DATA3: P1.7
SSPI_DETECT: JP1.1, P1.4
SSPI_SCK: P1.10
USB_DM: CON2.2 (D-), U1.1 (K1)
USB_DP: CON2.3 (D+), U1.2 (K2)
USB_ID: CON2.4 (ID), JP1.2
VBUS: C5.1, C6.1, CON2.1 (VBUS), D2.2 (K), L1.2
VDAC1: C2.1, P1.12, P3.1 (In)

Notes on the sheet:
USB_DM & USB_DP ROUTE WITH DIFFERENTIAL PAIR 90 OHM
USB
For applications that support cable-based detection of Host or Device modes.
AUDIO OUT
L1, L2, L3 should be as close as possible to the headphone jack.
The VIDEO_DAC ground should be routed as a star connection to the VAG capacitor.
VIDEO OUT
AUDIO IN
5VDC IN
LED 5VDC
