capantoja/SIMM/SIMM/Hardware/StampMini/template_mini/DDR1.sch

## KiCad design SIMM/Hardware/StampMini/template_mini/DDR1.sch (2013-09-21)

Schematic: DDR1.sch

Parts:
C61, C62, C63, C64, C65, C66, C67, C70, C71: 0.1uF
C69: 1uF
R7: 47k
R22: 110
R23: 47K
R24, R25: 1K 1%
U2: MT46V32M16TG; TSOP66_JEDEC_DDR_SDRAM

Notes on the sheet:
DDR RAM
