capantoja/SIMM/SIMM/Hardware/StampMini/template_mini/POWER_SUPPLY.sch

## KiCad design SIMM/Hardware/StampMini/template_mini/POWER_SUPPLY.sch (2013-09-21)

Schematic: POWER_SUPPLY.sch

Parts:
C41, C42, C53: 100n
C56: 10u
D7: LED
J11, J12: HOLE1
J13: HOLE3
J14: HOLE4
J17: POWER
J18: HEADER_2
R31: 1K
U7: LT1117CST-1.8
U8: LT1117CST-3.3
