capantoja/SIMM/SIMM/Hardware/StampMini/template_mini/SAM3N.sch

## KiCad design SIMM/Hardware/StampMini/template_mini/SAM3N.sch (2013-09-21)

Schematic: SAM3N.sch

Parts:
C74, C76: 33uF; SM1206
C75: 100n; SM0603
C401, C404, C405, C408, C409, C410: 0.1uF; SM0603
C402, C403: 20 pF; SM0603
C406, C411: 1uF; SM0603
C407, C412: 4.7uF; SM1206
D8, D9: LED; SM0603
P4: CONN_12X2; pin_array_12x2
R5, R33: 1k; SM0603
U11: LT1117CST-3.3; LT1117
U401: ATSAM3N0AA-AU
X401: 12MHz; ABM8G

Notes on the sheet:
LEDS
