capantoja/SIMM/SIMM/Hardware/StampMini/template_mini/STM32.sch

## KiCad design SIMM/Hardware/StampMini/template_mini/STM32.sch (2013-09-21)

Schematic: STM32.sch

Parts:
C74, C76: 33uF; SM1206
C75: 100n; SM0603
D8, D9: LED; SM0603
R5, R33: 1k; SM0603
U11: LT1117CST-3.3; LT1117

Notes on the sheet:
LEDS
