capantoja/SIMM/SIMM/Hardware/StampMini/template_mini/i.MX233.sch

## KiCad design SIMM/Hardware/StampMini/template_mini/i.MX233.sch (2013-09-21)

Schematic: i.MX233.sch

Parts:
BT1: BATTERY
C17, C25, C29, C38, C42, C43, C50: 1uF
C22, C30, C36, C45: 0.01uF
C23, C24, C31, C32, C37, C41, C44, C46, C47, C49, C51, C57, C60, C68: 0.1uF
C27, C35, C39: 33uF
C34: 4.7uF
C40, C48: 33uF Ceramic
C52, C53: 20 pF
D1: 10BQ015; SOD123
D2, D3, D4, D5: LED
IC1: iMX233
J1: MICROSD
JP1, JP2, JP3: JUMPER; SM0603
JP4: J; PIN_ARRAY_2X1
L1: 15uH
L2, L8: HZ0805D152R-10 (1500 ohm)
L11, L12, L13: HZ0805D152R-10 (1500 ohm); SM0805
P1: CONN_12X2
P2: CONN_12X2
P3, P5, P7, P10: CONN_1; MHOLE
Q1: MMDT3904; SOT363_PHILIPS
R1: 1
R2, R3: 0.1
R4: 1K
R6: 100K
R8, R51, R52: 10k
R9, R13, R16, R28, R30, R31: 1k
R10: 47K
R11, R12, R14: 1.5k
R15, R17, R18, R19: 11k
R29, R32: 47k
U3: M25P32; SO16W
X1: 24MHz; ABM8G

Notes on the sheet:
Para hacer boot por la SD soldar R48, R49 no se solda Para hacer boot por la memoria SPI soldar R49, R48 no se solda
ADM3101E CIRCUIT
Power Supply
MICRO_SD
IMX233 PROCESSOR
POWER SUPPLY AND DECOUPLING
BOOT MODES
RESET CIRCUIT
