capantoja/SIMM/SIMM/Hardware/StampMini/template_mini/stamp_mini_4.sch

## KiCad design SIMM/Hardware/StampMini/template_mini/stamp_mini_4.sch (2013-09-21)

Schematic: stamp_mini_4.sch

Parts:
JP4: J; PIN_ARRAY_2X1
P1: CONN_12X2
P2: CONN_12X2
P3, P5, P7, P10: CONN_1; MHOLE
P4: CONN_12X2; pin_array_12x2
