capantoja/SIMM/(commit log)

2013-08-06 Sistema de informacion Multimedia
2013-08-28 mar 27 /13
    [ENTRADAS.sch, OBSERVACIONES.sch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]
2013-09-21 Subido Sept 1/2013
    [BOM.xlsx]
2013-09-21 subido setp 1/2013
    [DDR1.sch, LCD.sch, MAIN.sch, PCBC.brd, PCBC.sch, PCBC.xlsx, POWER.sch, POWER_SUPPLY.sch]
2013-09-21 Archivos eliminados
    [BOM.xlsx, ENTRADAS.sch, OBSERVACIONES.sch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]
2013-11-11 Kicad Length Matching
2014-08-10 rtl8192 driver add
2014-08-10 material add
